PSU-Practicum/Practicum-Project/Assignments/System Design/Module Descriptions.xlsx

Sheet: Tablero L0
Module | Tablero Game Board
Inputs | - Reset Button Signal
 | - Dice Roll Button Signal
 | - Power: 5V DC, Controlled by ON/OFF switch
 | - Placement of game pieces.
Outputs | - LCD Display
 | - LED lighting
Functionality | Enable a game of tablero to be played with enhanced experience.

Sheet: Tablero L1
Module | Reed Switch Matrix (7x7 Matrix)
Inputs | - Game Piece Position (analog)
Outputs | - Digital Signal stating piece is on game square or not (High/Low)
Functionality | Analog game piece position transformed into a digital signal by way of reed switch closing generating a high signal that is passed into microcontroller.
Module | PCB
Inputs | - RESET Signal (Digital High)
 | - Game Piece Position (Digital Signal from Reed Switch Matrix)
 | +5 VDC
 | - Dice Roll Signal (Digital High)
Outputs | - Data to light or turn off specific LEDs based on signals sent from reed switch matrix
 | +3.3 VDC
 | - String of characters to have LCD Display
Functionality | Provide inputs and outputs for microprocessor as well as 3.3V for LCD display.
Module | LED Grid (7x7 Matrix)
Inputs | - Array index data to illuminate or turn off specific LEDs (digital), powered by 5V DC
Outputs | - LEDs light up or shut off
Functionality | Each LED is an index in an array. Data is modified in each index to turn on or off an LED. LEDs are lit or turned off depending on whether a game piece is placed on a corresponding space located above each LED.
Module | LCD Display (2 Lines text)
Inputs | - String of characters (using I2C protocol), powered by 3.3V DC
Outputs | - String of characters or numbers on display.
Functionality | Using the I2C protocol a string of characters can be displayed on the LCD. This is to be used to display game data and give feedback to the user(s). Also used to display the dice rolls generated by the game.

Sheet: PCB L1
Module | Voltage Regulator
Inputs | +5 VDC
Outputs | +3.3 VDC
Functionality | Reduce voltage to a suitable level for the LCD display module
Module | Microprocessor
Inputs | - RESET Signal (Digital High)
 | - Game Piece Position (Digital Signal from Reed Switch Matrix)
 | - Dice Roll Signal (Digital High)
Outputs | - Data to LED strand
 | - String of characters to have LCD Display
Functionality | Control the flow of gameplay.
