PSU-Practicum/Practicum-Project/Enclosure Design/Enclosure Design 1.1.0.pdf

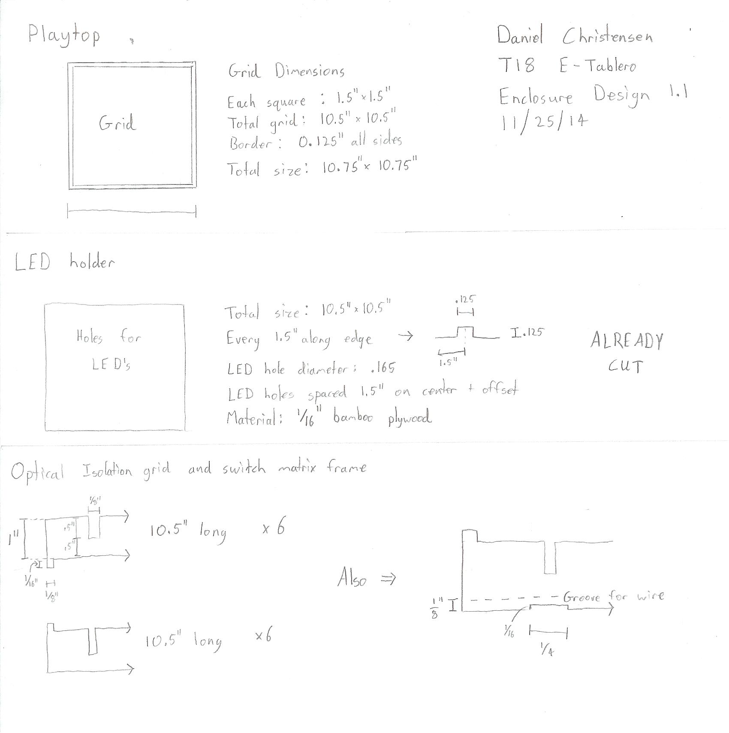
[picture p1: page 1]
