PSU-Practicum/Practicum-Project/Enclosure Design/Enclosure Design 1.0.0.pdf

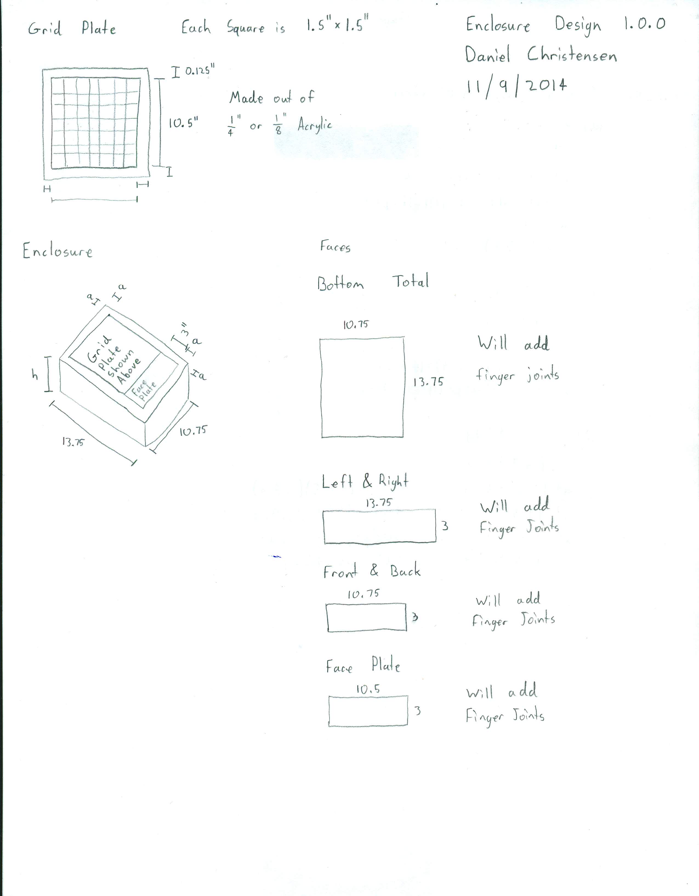
[picture p2: page 1]
