PSU-Practicum/Practicum-Project/Eagle/T18_cad.brd

## EAGLE design Eagle/T18_cad.brd (2014-11-10)

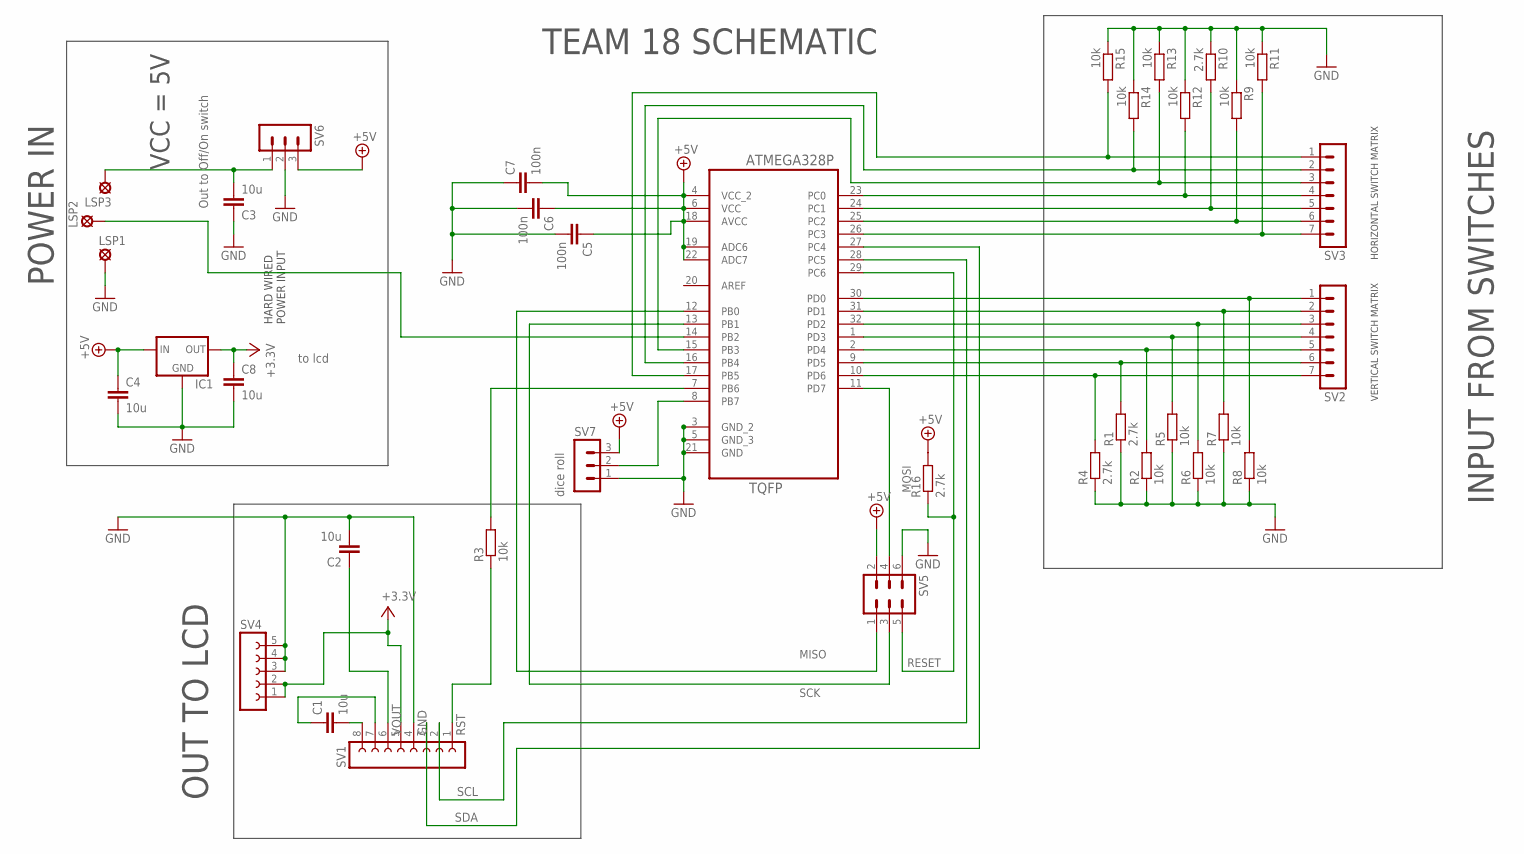
[picture p3: schematic T18_cad.sch]

Parts:
C1, C2, C3, C4, C8: 10u; C0603
C5, C6, C7: 100n; C0603
IC1: 78LXX
LSP1, LSP2, LSP3: SE14
R1, R4, R10, R16: 2.7k; R0603
R2, R3, R5, R6, R7, R8, R9, R11, R12, R13, R14, R15: 10k; R0603
SV1: FE08-1; FE08
SV2, SV3: MA07-1
SV4: FE05-1
SV5: MA03-2
SV6, SV7: MA03-1
U1: ATMEGA328P-AU; QFP80P900X900X120-32N

Connections:
+3.3V: C8.1, IC1.OUT, SV1.5, SV4.1, SV4.2
+5V: C4.1, C5.1, C6.1, C7.2, IC1.IN, R16.2, SV5.2, SV6.3, SV7.3, U1.4 (VCC_2), U1.6 (VCC), U1.18 (AVCC), U1.19 (ADC6), U1.22 (ADC7)
GND: C2.2, C3.1, C4.2, C5.2, C6.2, C7.1, C8.2, IC1.GND, LSP1.MP, R1.1, R2.1, R4.1, R5.1, R6.1, R7.1, R8.1, R9.1, R10.1, R11.1, R12.1, R13.1, R14.1, R15.1, SV1.4, SV4.3, SV4.4, SV4.5, SV5.6, SV6.2, SV7.1, U1.3 (GND_2), U1.5 (GND_3), U1.21 (GND)
MISO: SV5.1, U1.12 (PB0)
MOSI: SV5.4, U1.11 (PD7)
unnamed: R1.2, SV2.6, U1.9 (PD5)
unnamed: LSP2.MP, U1.14 (PB2)
unnamed: R5.2, SV2.4, U1.1 (PD3)
unnamed: R2.2, SV2.5, U1.2 (PD4)
unnamed: R6.2, SV2.3, U1.32 (PD2)
unnamed: R7.2, SV2.2, U1.31 (PD1)
unnamed: R8.2, SV2.1, U1.30 (PD0)
unnamed: R4.2, SV2.7, U1.10 (PD6)
unnamed: R11.2, SV3.7, U1.26 (PC3)
unnamed: C1.2, SV1.8
unnamed: C3.2, LSP3.MP, SV6.1
unnamed: R3.2, U1.7 (PB6)
unnamed: C1.1, SV1.7
unnamed: R9.2, SV3.6, U1.25 (PC2)
unnamed: R10.2, SV3.5, U1.24 (PC1)
unnamed: R12.2, SV3.4, U1.23 (PC0)
unnamed: R13.2, SV3.3, U1.15 (PB3)
unnamed: R14.2, SV3.2, U1.16 (PB4)
unnamed: R15.2, SV3.1, U1.17 (PB5)
RESET: R16.1, SV5.5, U1.29 (PC6)
RST: R3.1, SV1.1
SCK: SV5.3, U1.13 (PB1)
SCL: SV1.2, U1.28 (PC5)
SDA: SV1.3, U1.27 (PC4)
TESTPT: SV7.2, U1.8 (PB7)
VOUT: C2.1, SV1.6

Notes on the sheet:
TEAM 18 SCHEMATIC
OUT TO LCD
VERTICAL SWITCH MATRIX
HORIZONTAL SWITCH MATRIX
HARD WIRED POWER INPUT
VCC = 5V
INPUT FROM SWITCHES
POWER IN
Out to Off/On switch
dice roll
to lcd

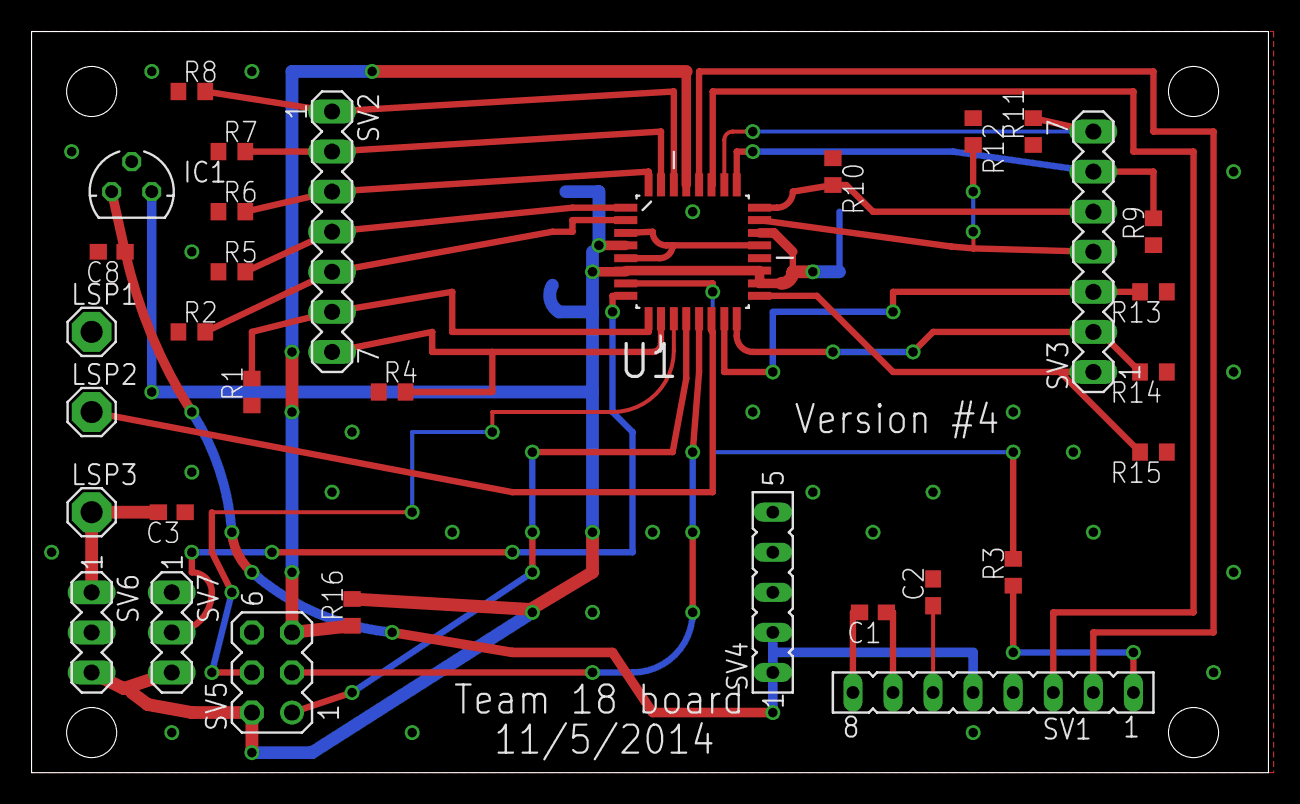
[picture p4: board T18_cad.brd from above]

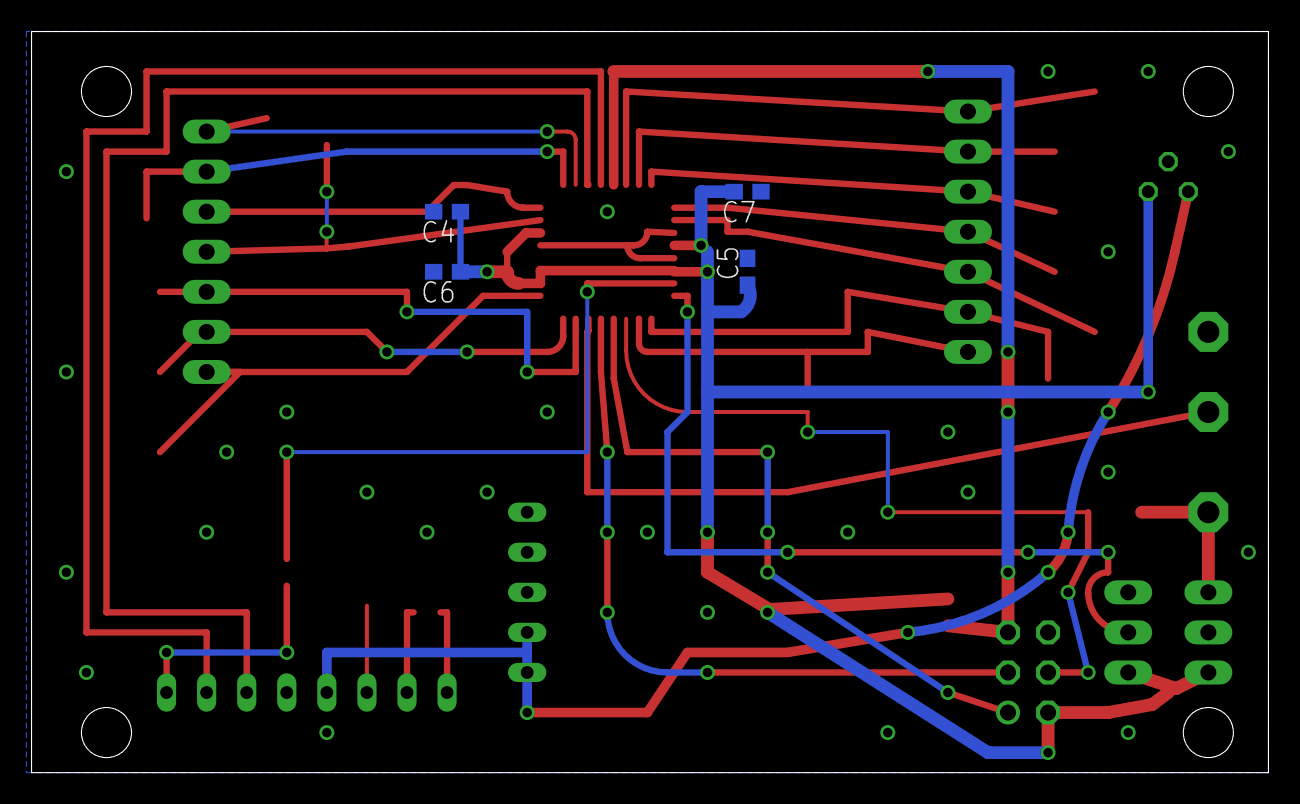
[picture p5: board T18_cad.brd from below]

Board: 2 copper layers, 78.4 x 47.0 mm, 36 parts (4 on the bottom side), 31 nets.
