PSU-Practicum/Practicum-Project/Assignments/test cases.xlsx

Sheet: Sheet1
Test Writer: Team 18
Test Case Name: |  | Finite State Machine |  |  | Test ID# |  |  | FSM
Description: |  | perform every possible state transition and check the new state. Test passes if every transition is as expected. goes to the correct state. |  |  | Type:
Tester Information
Name of Tester: |  |  |  |  | Date :
Hardware version: |  |  |  |  | Time:
Setup: |  | After all dependent modules are implemented, play a game of tablero. Continue to play the game until every possible state transition has been tested.
Test |  |  |  |  | Pass | Fail | N/A | Comments
1 | Beginning State | Action | Expected State | Observed State
 | Initial Placement | Place Pieces | Dice Roll
 | Dice Roll | Pick a piece | Invalid
 |  | Press Roll Button | Dice Roll
 |  |  | Move 1, pre-pick
 | Move 1, pre-pick | Pick a piece | Move 1, post-pick
 | Move 1, post-pick | Pick a piece | Invalid
 |  | Invalid placement | Invalid
 |  | valid placement | Initial Placement
 |  |  | Move 2, pre-pick
 | Move 2, pre-pick | Pick a piece | Move 2, post-pick
 | Move 2, post-pick | Pick a piece | Invalid
 |  | Invalid placement | Invalid
 |  | valid placement | Initial Placement
 |  |  | Dice Roll
Test Writer: Team 18
Test Case Name: |  | Reed Switch Matrix |  |  | Test ID# |  |  | Matrix
Description: |  | Check that each square recognizes a play piece |  |  | Type:
Tester Information
Name of Tester: |  |  |  |  | Date :
Hardware version: |  |  |  |  | Time:
Setup: |  | Program the uP to simply illuminate any sqaure that has a magnet on it. Place and remove a magnet on every square to ensure that the square illuminates, and that only the square that has a magnet illuminates. Test fails if any square fails to illuminate with a magnet or illuminates without a magnet.
Test |  |  |  |  | Pass | Fail | N/A | Comments
 |  | Square Index (Row, Column) | No magnet | With Magnet
 |  | 1,1
 |  | 2,1
 |  | 3,1
 |  | 4,1
 |  | 5,1
 |  | 6,1
 |  | 7,1
 |  | 1,2
 |  | 2,2
 |  | 3,2
 |  | 4,2
 |  | 5,2
 |  | 6,2
 |  | 7,2
 |  | 1,3
 |  | 2,3
 |  | 3,3
 |  | 4,3
 |  | 5,3
 |  | 6,3
 |  | 7,3
 |  | 1,4
 |  | 2,4
 |  | 3,4
 |  | 4,4
 |  | 5,4
 |  | 6,4
 |  | 7,4
 |  | 1,5
 |  | 2,5
 |  | 3,5
 |  | 4,5
 |  | 5,5
 |  | 6,5
 |  | 7,5
 |  | 1,6
 |  | 2,6
 |  | 3,6
 |  | 4,6
 |  | 5,6
 |  | 6,6
 |  | 7,6
 |  | 1,7
 |  | 2,7
 |  | 3,7
 |  | 4,7
 |  | 5,7
 |  | 6,7
 |  | 7,7
Test Writer: Team 18
Test Case Name: |  | LED Strand |  |  | Test ID# |  |  | LED
Description: |  | Test the functionality of the LED strand while connected to the finished PCB |  |  | Type:
Tester Information
Name of Tester: |  |  |  |  | Date :
Hardware version: |  |  |  |  | Time:
Setup: |  | Connect the LED strand to the finished PCB. Program the microprocessor to illuminate all LEDs in a sequential on/off pattern slow enough for the tester to identify any faulty LEDs. Start by illuminating in one of the basic colors. repeat the test with the other two basic colors. Test passes if all LEDs illuminate as expected.
Test |  |  |  |  | Pass | Fail | N/A | Comments
 |  | Light index | Red | Green
 |  | 1
 |  | 2
 |  | 3
 |  | 4
 |  | 5
 |  | 6
 |  | 7
 |  | 8
 |  | 9
 |  | 10
 |  | 11
 |  | 12
 |  | 13
 |  | 14
 |  | 15
 |  | 16
 |  | 17
 |  | 18
 |  | 19
 |  | 20
 |  | 21
 |  | 22
 |  | 23
 |  | 24
 |  | 25
 |  | 26
 |  | 27
 |  | 28
 |  | 29
 |  | 30
 |  | 31
 |  | 32
 |  | 33
 |  | 34
 |  | 35
 |  | 36
 |  | 37
 |  | 38
 |  | 39
 |  | 40
 |  | 41
 |  | 42
 |  | 43
 |  | 44
 |  | 45
 |  | 46
 |  | 47
 |  | 48
 |  | 49
 |  | 50
Test Writer: | Team 18
Test Case Name: |  | LCD Display |  |  | Test ID# |  |  | LCD
Description: |  |  |  |  | Type:
Tester Information
Name of Tester: |  |  |  |  | Date :
Hardware version: |  |  |  |  | Time:
Setup: |  | With finished and tested PCB, Send characters to LCD, verify appropriate characters are displayed.
Test | 1 | Chararcters Sent | Characters received |  | Pass | Fail | N/A | Comments

Sheet: Sheet2
1,1 | 1,2 | 1,3 | 1,4 | 1,5 | 1,6 | 1,7
2,1 | 2,2 | 2,3 | 2,4 | 2,5 | 2,6 | 2,7
3,1 | 3,2 | 3,3 | 3,4 | 3,5 | 3,6 | 3,7
4,1 | 4,2 | 4,3 | 4,4 | 4,5 | 4,6 | 4,7
5,1 | 5,2 | 5,3 | 5,4 | 5,5 | 5,6 | 5,7
6,1 | 6,2 | 6,3 | 6,4 | 6,5 | 6,6 | 6,7
7,1 | 7,2 | 7,3 | 7,4 | 7,5 | 7,6 | 7,7
