PSU-Practicum/Practicum-Project/(commit log)

2014-11-10 Showing Daniel whats up
    [T18_cad.brd, T18_cad.sch]
2014-11-12 Enclosure Design Update
    Started adding the enclosure design files.
2014-11-14 Enclosure Design Summary
    Finished Design, removed temp files
2014-11-15 Create Bill of Materials
2014-11-18 Project Model homework
    [Module Descriptions.xlsx]
2014-11-18 Rename Folder
    [Module Descriptions.xlsx]
2014-11-20 Update Enclosure Design
    Added file for the bottom of enclosure (with fingering!) and file for
    pieces of optical isolation grid.
2014-11-26 Finished LED grid and OI grid
    If you want to cut these pieces, let me know first. We don't need any
    duplicates.
2014-11-27 Updated enclosure design
    Uploaded new design file.
2014-12-02 Enclosure vector graphics
2014-12-03 Test plan and test cases for tablero game board
    [test cases.xlsx]
2014-12-12 Final Update
    BOM, Final code, some other organizational stuff
